vitkorob/beetle/beetle.kicad_pcb

## KiCad design beetle.kicad_pcb (2020-05-12)

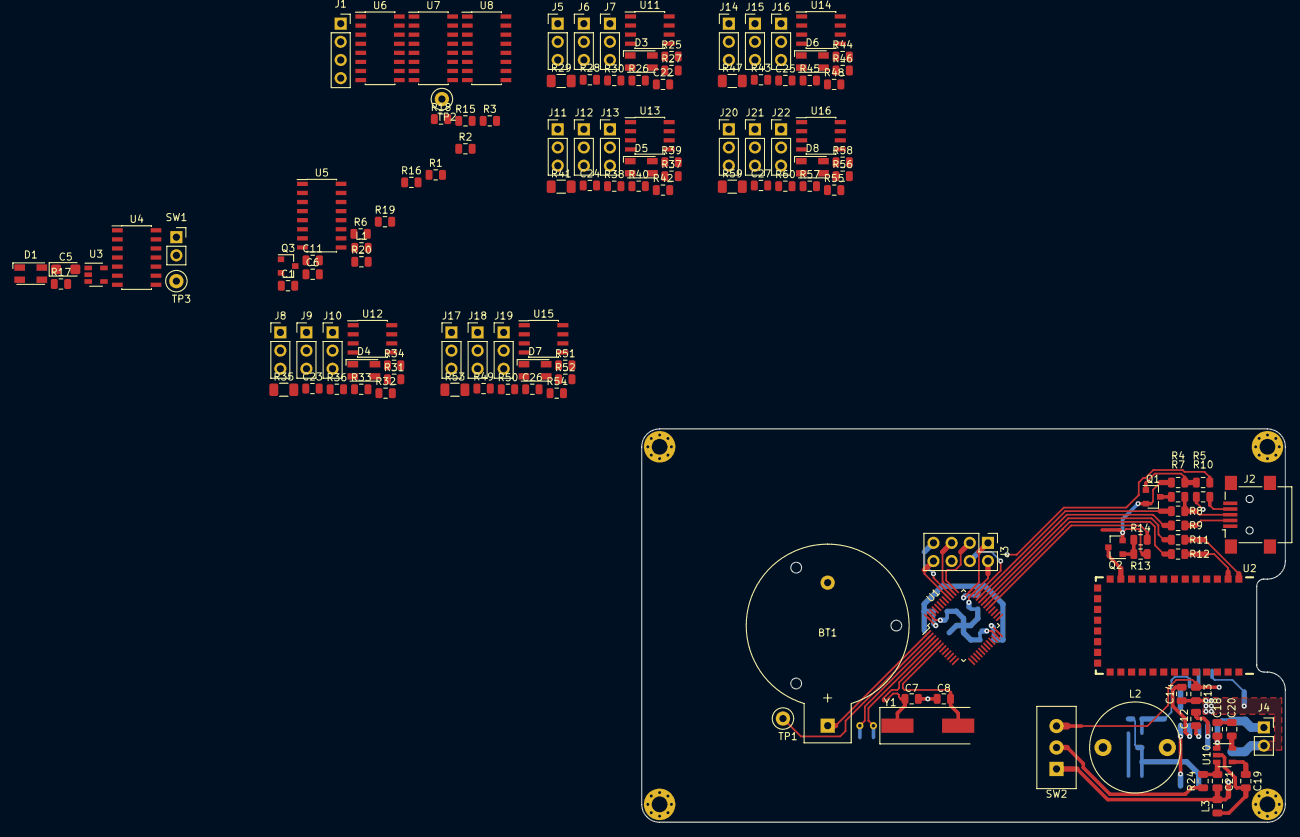
[picture p1: board beetle.kicad_pcb from above]

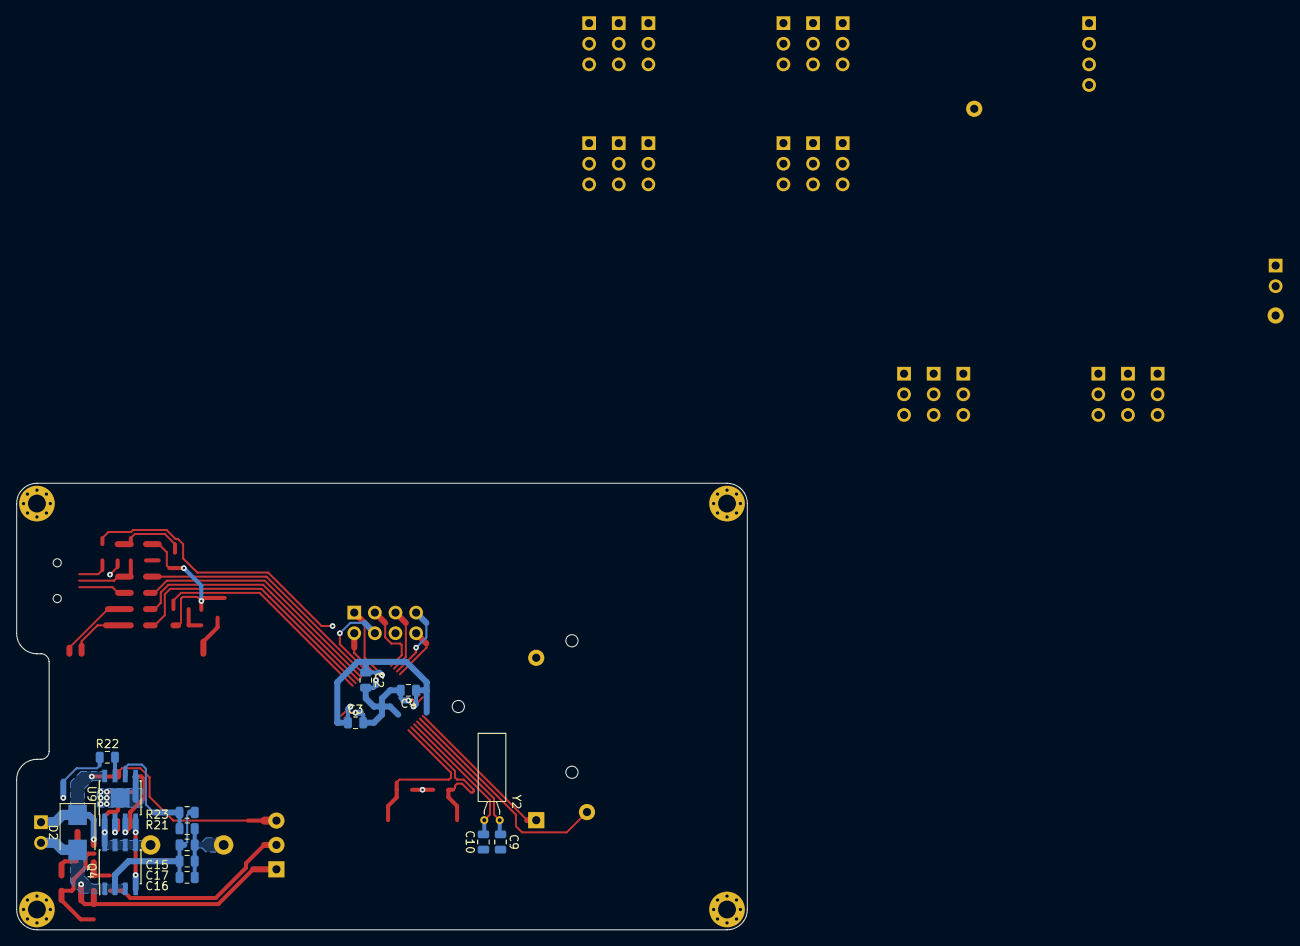
[picture p2: board beetle.kicad_pcb from below]

Board: 2 copper layers, 90.0 x 55.0 mm, 148 parts (15 on the bottom side), 118 nets.

Parts:
BT1: 1V8-3V6; CH25-2032LF
C1, C2, C3, C4, C6, C11, C21, C22, C23, C24, C25, C26, C27: 100nF; C_0805_2012Metric
C5: 1uF; CP_EIA-3216-12_Kemet-S
C7, C8: 22pF; C_0805_2012Metric
C9, C10: 10pF; C_0805_2012Metric
C12, C14, C18: 1uF; C_0805_2012Metric
C13, C15, C16, C17: 22uF; C_0805_2012Metric
C19: 10nF; C_0805_2012Metric
C20: 2.2uF; C_0805_2012Metric
D1, D3, D4, D5, D6, D7, D8: LED_Dual_AACC; LED_Wurth_PLCC4_3.2x2.8mm
D2: 9V1; D_SMB
J1: Conn_01x04; PinSocket_1x04_P2.54mm_Vertical
J2: USB_OTG; USB_Mini-B_Lumberg_2486_01_Horizontal
J3: JTAG; PinHeader_2x04_P2.54mm_Vertical
J4: LiPo 2S; PinSocket_1x02_P2.54mm_Vertical
J5, J6, J7, J8, J9, J10, J11, J12, J13, J14, J15, J16, J17, J18, J19, J20, J21, J22: Conn_01x03; PinHeader_1x03_P2.54mm_Vertical
L1, L3: 600R @ 100MHz; L_0805_2012Metric
L2: 3.3uH; L_Radial_D12.5mm_P9.00mm_Fastron_09HCP
Q1, Q2: Q_PNP_BEC; SOT-23
Q3: Q_NPN_BEC; SOT-23
Q4: AO4752; SOIC-8_3.9x4.9mm_P1.27mm
R1, R2, R11, R12, R15, R16, R24, R28, R30, R34, R36, R40, R42, R46, R48, R52, R54, R58, R60: 470; R_0805_2012Metric
R3, R5, R14, R17, R18, R19, R25, R26, R27, R31, R32, R33, R37, R38, R39, R43, R44, R45, R49, R50, R51, R55, R56, R57: 10k; R_0805_2012Metric
R4, R6, R10, R13, R20, R22: 100k; R_0805_2012Metric
R7: 1k5; R_0805_2012Metric
R8, R9: 22; R_0805_2012Metric
R21: 95k3; R_0805_2012Metric
R23: 15k; R_0805_2012Metric
R29, R35, R41, R47, R53, R59: 0.05; R_1206_3216Metric
SW1: SW_Push; PinSocket_1x02_P2.54mm_Vertical
SW2: SW_SPDT; SPDT_P3mm
TP1: TEST; TestPoint_Loop_D2.50mm_Drill1.0mm
TP2: +3V3; TestPoint_Loop_D2.50mm_Drill1.0mm
TP3: GND; TestPoint_Loop_D2.50mm_Drill1.0mm
U1: STM32F103C8Tx; LQFP-48_7x7mm_P0.5mm
U2: HC-06; HC-06_P1.5mm
U3: NC7S08M5; SOT-23-5
U4: 74HC393D; SOIC-14_3.9x8.7mm_P1.27mm
U5, U6, U7, U8: 74HC595D; SOIC-16_3.9x9.9mm_P1.27mm
U9: RT8298; SOIC-8-1EP_3.9x4.9mm_P1.27mm_EP2.35x2.35mm
U10: LP2985-3.3; SOT-23-5
U11, U12, U13, U14, U15, U16: MAX4173FESA+; SOIC-8_3.9x4.9mm_P1.27mm
Y1: 8MHz; Crystal_SMD_HC49-SD
Y2: 32.768kHz; Crystal_C38-LF_D3.0mm_L8.0mm_Horizontal

Connections:
+6V: C15.1, C16.1, C17.1, L2.1, R21.1, R29.1, R35.1, R41.1, R47.1, R53.1, R59.1, U11.8, U12.8, U13.8, U14.8, U15.8, U16.8
+8V: C13.1, C18.1, D2.1, J4.1, SW2.3, U9.8, U10.1
+BATT: BT1.1, U1.1
/BTRX: R12.2, U1.30
/BTTX: R11.2, U1.31
/CLER: Q3.3, R18.2, U4.2
/CURR0: U1.11, U11.4
/CURR1: U1.12, U12.4
/CURR2: U1.13, U13.4
/CURR3: U1.14, U14.4
/CURR4: U1.18, U15.4
/CURR5: U1.19, U16.4
/DISC: R5.2, U1.41
/DM: R9.1, U1.32
/DP: R8.1, U1.33
/ECHO: J1.3, U1.45
/EN: R22.1, U1.26, U9.7
/INIT: D1.2, U1.28
/LED0: D3.1, U5.15
/LED1: D3.2, U5.1
/LED2: D4.1, U6.1
/LED3: D4.2, U6.2
/LED4: D5.1, U6.6
/LED5: D5.2, U6.7
/LED6: D6.1, U7.1
/LED7: D6.2, U7.2
/LED8: D7.1, U7.6
/LED9: D7.2, U7.7
/LED10: D8.1, U8.3
/LED11: D8.2, U8.4
/LEG0: J5.1, R25.1, U5.2
/LEG1: J6.1, R26.1, U5.3
/LEG2: J7.1, R27.1, U5.4
/LEG3: J8.1, R31.1, U5.5
/LEG4: J9.1, R32.1, U5.6
/LEG5: J10.1, R33.1, U5.7
/LEG6: J11.1, R37.1, U6.3
/LEG7: J12.1, R38.1, U6.4
/LEG8: J13.1, R39.1, U6.5
/LEG9: J14.1, R43.1, U7.3
/LEG10: J15.1, R44.1, U7.4
/LEG11: J16.1, R45.1, U7.5
/LEG12: J17.1, R49.1, U8.15
/LEG13: J18.1, R50.1, U8.1
/LEG14: J19.1, R51.1, U8.2
/LEG15: J20.1, R55.1, U8.5
/LEG16: J21.1, R56.1, U8.6
/LEG17: J22.1, R57.1, U8.7
/Leg0/PWR: J5.2, J6.2, J7.2, R29.2, U11.6
/Leg1/PWR: J8.2, J9.2, J10.2, R35.2, U12.6
/Leg2/PWR: J11.2, J12.2, J13.2, R41.2, U13.6
/Leg3/PWR: J14.2, J15.2, J16.2, R47.2, U14.6
/Leg4/PWR: J17.2, J18.2, J19.2, R53.2, U15.6
/Leg5/PWR: J20.2, J21.2, J22.2, R59.2, U16.6
/Power/~OFF: C21.1, R24.1, U10.3
/RCLK: U3.4, U5.12, U6.12, U7.12, U8.12
/SHCL: U1.15, U5.11, U6.11, U7.11, U8.11
/SHDT: U1.17, U5.14
/STCL: U1.22, U3.2, U4.1
/TCK: J3.3, U1.37
/TDI: J3.5, U1.38
/TDO: J3.7, U1.39
/TMS: J3.4, U1.34
/TRIG: J1.2, U6.15
/WKUP: R2.1, U1.10
/~BTON: R14.2, U1.29
/~CLER: R19.2, U1.21, U5.10, U6.10, U7.10, U8.10
/~NRST: C11.1, J3.6, R17.2, U1.7
/~OUEN: R6.2, U1.16, U5.13, U6.13, U7.13, U8.13
/~TRST: J3.8, U1.40
GND: BT1.2, C1.2, C2.2, C3.2, C4.2, C5.2, C6.2, C7.2, C8.2, C9.2, C10.2, C11.2, C18.2, C19.2, C20.2, C22.2, C23.2, C24.2, C25.2, C26.2, C27.2, J1.4, J2.5, J2.6, J3.2, L3.1, Q3.2, R3.2, R10.1, R15.1, R16.1, R20.1, R25.2, R26.2, R27.2, R28.1, R30.1, R31.2, R32.2, R33.2, R34.1, R36.1, R37.2, R38.2, R39.2, R40.1, R42.1, R43.2, R44.2, R45.2, R46.1, R48.1, R49.2, R50.2, R51.2, R52.1, R54.1, R55.2, R56.2, R57.2, R58.1, R60.1, TP3.1, U1.8, U1.23, U1.35, U1.47, U2.13, U2.21, U2.22, U3.3, U4.7, U5.8, U6.8, U7.8, U8.8, U10.2, U11.3, U12.3, U13.3, U14.3, U15.3, U16.3
GNDPWR: C13.2, C14.2, C15.2, C16.2, C17.2, C21.2, D2.2, J4.2, J5.3, J6.3, J7.3, J8.3, J9.3, J10.3, J11.3, J12.3, J13.3, J14.3, J15.3, J16.3, J17.3, J18.3, J19.3, J20.3, J21.3, J22.3, L3.2, Q4.1, Q4.2, Q4.3, R22.2, R23.2, SW2.1, U9.5, U9.9
unnamed: C1.1, R1.1, R2.2
unnamed: C7.1, U1.5, Y1.1
unnamed: C8.1, U1.6, Y1.2
unnamed: C9.1, U1.3, Y2.1
unnamed: C10.1, U1.4, Y2.2
unnamed: C12.1, U9.2
unnamed: C12.2, L2.2, Q4.5, Q4.6, Q4.7, Q4.8, U9.1
unnamed: C14.1, U9.3
unnamed: C19.1, U10.4
unnamed: D1.1, U2.24
unnamed: D1.3, R15.2
unnamed: D1.4, R16.2
unnamed: D3.3, R28.2
unnamed: D3.4, R30.2
unnamed: D4.3, R34.2
unnamed: D4.4, R36.2
unnamed: D5.3, R40.2
unnamed: D5.4, R42.2
unnamed: D6.3, R46.2
unnamed: D6.4, R48.2
unnamed: D7.3, R52.2
unnamed: D7.4, R54.2
unnamed: D8.3, R58.2
unnamed: D8.4, R60.2
unnamed: J2.2, R9.2
unnamed: J2.3, R7.2, R8.2
unnamed: J2.4, R10.2
unnamed: Q1.1, R4.2, R5.1
unnamed: Q1.3, R7.1
unnamed: Q2.1, R13.2, R14.1
unnamed: Q2.3, U2.12
unnamed: Q3.1, R19.1, R20.2
unnamed: Q4.4, U9.4
unnamed: R1.2, SW1.2
unnamed: R3.1, U1.44
unnamed: R11.1, U2.1
unnamed: R12.1, U2.2
unnamed: R21.2, R23.1, U9.6
unnamed: R24.2, SW2.2
unnamed: TP1.1, U1.2
unnamed: U3.1, U4.3
unnamed: U5.9, U6.14
unnamed: U6.9, U7.14
unnamed: U7.9, U8.14
VCC: C2.1, C3.1, C4.1, C20.1, C22.1, C23.1, C24.1, C25.1, C26.1, C27.1, J1.1, J3.1, L1.1, Q1.2, Q2.2, R4.1, R6.1, R13.1, R17.1, R18.1, SW1.1, TP2.1, U1.24, U1.36, U1.48, U3.5, U4.14, U5.16, U6.16, U7.16, U8.16, U10.5, U11.1, U12.1, U13.1, U14.1, U15.1, U16.1
VDDA: C5.1, C6.1, L1.2, U1.9
