vitkorob/beetle/(commit log)

2018-04-21 Initional commit
    [beetle.sch]
2018-04-21 Clarification of footprints
    [beetle.sch]
2018-04-22 Four 74HC595 have been added
    [beetle.sch]
2018-04-22 SPI to PWM converter is complete
    [beetle.sch]
2018-04-30 Adding the new lib
    [beetle.sch]
2020-05-12 Sheet with power has been added
    [beetle.kicad_pcb, beetle.sch, leg.sch, power.sch]
